LeNguyet68/xe_dieu_khien_tu_xa_nangcap/1.jpg

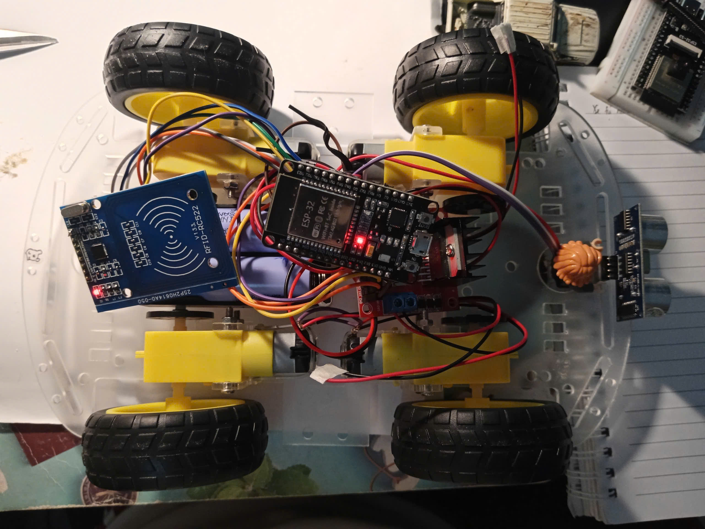
1.jpg
