LeNguyet68/xe_dieu_khien_tu_xa_nangcap/README.md

# xe_dieu_khien_tu_xa_nangcap
update thẻ mở khóa xe &amp; tự dừng khi gặp vật cản
